eugene1028csh/RISC-V-NNA-SoC/docs/hardware/fpga_healthy2.jpeg

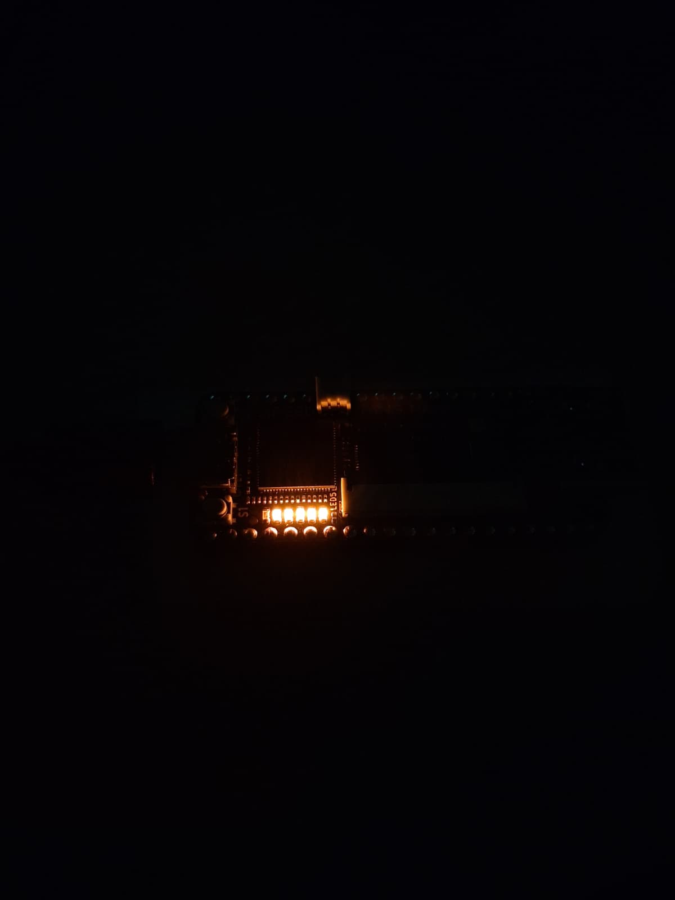
docs/hardware/fpga_healthy2.jpeg
