eugene1028csh/RISC-V-NNA-SoC/rtl/cpu/rv32i_core.sv

import rv32i_types::*;

module rv32i_core (
    input logic clk,
    input logic reset,
    input  logic nna_boot_pass_i,
    output logic core_dft_ready_o,

    //mmio ports
    output logic [31:0] bus_addr,
    output logic [31:0] bus_write_data,
    output logic        bus_write_en,

    input  logic [31:0] bus_read_data,
    input  logic        bus_hit,
    
    // MBIST status
    output logic        mbist_pass_o,
    output logic        mbist_fail_o,

    output logic alu_lbist_pass_o,
    output logic crc_lbist_pass_o
    
);
    logic [31:0] pc;
    logic [31:0] next_pc;
    logic [31:0] pc_plus4;
    logic [31:0] instruction;

    logic [4:0]  rs1_addr;
    logic [4:0]  rs2_addr;
    logic [4:0]  rd_addr;

    logic [31:0] rs1_data;
    logic [31:0] rs2_data;
    logic [31:0] writeback_data;

    logic [31:0] immediate;

    logic [31:0] alu_a;
    logic [31:0] alu_b;
    logic [31:0] alu_result;
    logic        alu_lbist_mode;
    logic [31:0] alu_lbist_a;
    logic [31:0] alu_lbist_b;
    alu_op_t     alu_lbist_op;
    logic        alu_lbist_start;
    logic        alu_lbist_busy;
    logic        alu_lbist_done;
    logic        alu_lbist_pass;
    logic        alu_lbist_fail;
    logic [31:0] alu_lbist_signature;
    logic alu_lbist_started;
    logic alu_lbist_boot_pass;

    logic [31:0] mem_read_data;
    logic [31:0] dmem_read_data;
    logic [31:0] crc_result;
    logic        crc_lbist_mode;
    logic        crc_lbist_start;
    logic        crc_lbist_busy;
    logic        crc_lbist_done;
    logic        crc_lbist_pass;
    logic        crc_lbist_fail;

    logic [31:0] crc_lbist_signature;
    logic crc_lbist_started;
    logic crc_lbist_boot_pass;
    logic [31:0] crc_lbist_rs1_data;
    logic [31:0] crc_lbist_rs2_data;
    logic [1:0]  crc_lbist_sel;
    logic        crc_ready;
    logic        crc_writeback;
    logic        crc_illegal;

    logic        reg_write;
    logic        alu_src;
    logic        alu_a_pc;
    logic        mem_write;
    logic        branch;
    logic        branch_taken;
    logic        jump;
    logic        jalr;

    alu_op_t      alu_op;
    imm_type_t    imm_type;
    result_src_t  result_src;

    // CPU-side DMEM signals
    logic [31:0] cpu_dmem_addr;
    logic [31:0] cpu_dmem_wdata;
    logic        cpu_dmem_we;

    // MBIST-side DMEM signals
    logic [31:0] mbist_mem_addr;
    logic [31:0] mbist_mem_wdata;
    logic        mbist_mem_we;

    logic        mbist_start;
    logic        mbist_busy;
    logic        mbist_done;
    logic        mbist_pass;
    logic        mbist_fail;
    logic [31:0] mbist_fail_addr;

    logic       repair_valid; //spare mapping is active
    logic [7:0] repair_addr; //which logical word gets redirected
    logic       repair_attempted; //we've already consumed our one spare

    // Actual signals entering physical DMEM
    logic [31:0] dmem_addr_mux;
    logic [31:0] dmem_wdata_mux;
    logic        dmem_we_mux;

    logic mbist_started;
    logic mbist_boot_pass;

    logic cpu_enable;
    logic cpu_reset;

    //instantiating pc
    rv32i_pc pc_unit (
        .clk(clk),
        .reset(cpu_reset),
        .next_pc(next_pc),
        .pc(pc)
    );

    //connect pc to imem
    rv32i_imem imem (
        .addr(pc),
        .instruction(instruction)
    );

    //instruction field extration for register addresses
    assign rs1_addr = instruction[19:15];
    assign rs2_addr = instruction[24:20];
    assign rd_addr  = instruction[11:7];

    xicrc_accelerator_unit xicrc_unit (
        .ext_rs1_data (
            crc_lbist_mode ? crc_lbist_rs1_data : rs1_data
        ),
        .ext_rs2_data (
            crc_lbist_mode ? crc_lbist_rs2_data : rs2_data
        ),
        .ext_funct7 (
            crc_lbist_mode ? 7'b1000000 : instruction[31:25]
        ),
        .ext_funct3 (
            crc_lbist_mode ? {1'b0, crc_lbist_sel} : instruction[14:12]
        ),

        .ext_ready     (crc_ready),
        .ext_result    (crc_result),
        .ext_writeback (crc_writeback),
        .ext_illegal   (crc_illegal)
    );

    rv32i_xicrc_lbist #(
        .USE_EXTERNAL_CRC(1'b1)
    ) crc_lbist_inst (
        .clk                 (clk),
        .reset               (reset),
        .start               (crc_lbist_start),

        .inject_fault        (1'b0),
        .fault_bit           (4'd0),
        .fault_stuck_at      (1'b0),

        .external_crc_result (crc_result[15:0]),

        .busy                (crc_lbist_busy),
        .done                (crc_lbist_done),
        .pass                (crc_lbist_pass),
        .fail                (crc_lbist_fail),

        .signature           (crc_lbist_signature),

        .test_rs1_data       (crc_lbist_rs1_data),
        .test_rs2_data       (crc_lbist_rs2_data),
        .test_crc_sel        (crc_lbist_sel)
    );

    assign crc_lbist_mode  = crc_lbist_busy;
    assign crc_lbist_start = alu_lbist_boot_pass && !crc_lbist_started;

    //instantiating decoder
    rv32i_decoder decoder (
        .instruction(instruction),
        .reg_write(reg_write),
        .alu_src(alu_src),
        .alu_a_pc(alu_a_pc),
        .mem_write(mem_write),
        .result_src(result_src),
        .branch(branch),
        .jump(jump),
        .jalr(jalr),
        .alu_op(alu_op),
        .imm_type(imm_type)
    );

    //reg file
    rv32i_regfile regfile (
    .clk(clk),
    .write_en(reg_write && cpu_enable), //connect the register file’s write_en input to the core’s reg_write signal.
    .rs1_addr(rs1_addr),
    .rs2_addr(rs2_addr),
    .wr_addr(rd_addr),
    .wr_data(writeback_data),
    .rs1_data(rs1_data),
    .rs2_data(rs2_data)
    );

    //immediate generator
    rv32i_imme_gnrtr immgen (
    .instruction(instruction),
    .imm_type(imm_type),
    .immediate(immediate)
    );

    assign alu_a = alu_a_pc ? pc : rs1_data;
    assign alu_b = alu_src ? immediate : rs2_data;
    assign alu_lbist_mode  = alu_lbist_busy;
    assign alu_lbist_start = mbist_boot_pass && !alu_lbist_started;

    rv32i_alu alu (
        .operand_a(alu_lbist_mode ? alu_lbist_a : alu_a),
        .operand_b(alu_lbist_mode ? alu_lbist_b : alu_b),
        .alu_op   (alu_lbist_mode ? alu_lbist_op : alu_op),
        .result   (alu_result)
    );

    rv32i_alu_lbist #(
        .USE_EXTERNAL_ALU(1'b1)
    ) alu_lbist_inst (
        .clk                 (clk),
        .reset               (reset),
        .start               (alu_lbist_start),

        .inject_fault        (1'b0),
        .fault_bit           (5'd0),
        .fault_stuck_at      (1'b0),

        .external_alu_result (alu_result),

        .busy                (alu_lbist_busy),
        .done                (alu_lbist_done),
        .pass                (alu_lbist_pass),
        .fail                (alu_lbist_fail),

        .signature           (alu_lbist_signature),

        .test_operand_a      (alu_lbist_a),
        .test_operand_b      (alu_lbist_b),
        .test_alu_op         (alu_lbist_op)
    );

    rv32i_branch_unit branch_unit (
        .rs1_data(rs1_data),
        .rs2_data(rs2_data),

        .funct3(instruction[14:12]),

        .branch_taken(branch_taken)
    );

    assign bus_addr =
        cpu_enable ? alu_result : 32'h0000_0000;

    assign bus_write_data =
        cpu_enable ? rs2_data : 32'h0000_0000;

    assign bus_write_en =
        mem_write && cpu_enable;

    rv32i_dmem dmem (
        .clk(clk),
        .mem_write(dmem_we_mux),

        .addr(dmem_addr_mux),
        .write_data(dmem_wdata_mux),

        .read_data(dmem_read_data),

        .repair_addr  (repair_addr),
        .repair_valid (repair_valid)
    );

    assign cpu_dmem_addr  = alu_result;
    assign cpu_dmem_wdata = rs2_data;
    assign cpu_dmem_we =    mem_write && !bus_hit && cpu_enable;
    assign dmem_addr_mux =
        mbist_busy ? mbist_mem_addr : cpu_dmem_addr;

    assign dmem_wdata_mux =
        mbist_busy ? mbist_mem_wdata : cpu_dmem_wdata;

    assign dmem_we_mux =
        mbist_busy ? mbist_mem_we : cpu_dmem_we;
    
    assign alu_lbist_pass_o = alu_lbist_boot_pass;
    assign crc_lbist_pass_o = crc_lbist_boot_pass;

    assign core_dft_ready_o =
        mbist_boot_pass &&
        alu_lbist_boot_pass &&
        crc_lbist_boot_pass;

    assign cpu_enable =
        core_dft_ready_o && nna_boot_pass_i;

    assign cpu_reset = reset || !cpu_enable;

    assign mbist_pass_o = mbist_pass;
    assign mbist_fail_o = mbist_fail;
    dmem_mbist #(
        .ADDR_WIDTH(8)
    ) mbist_inst (
        .clk       (clk),
        .reset     (reset),
        .start     (mbist_start),

        .busy      (mbist_busy),
        .done      (mbist_done),
        .pass      (mbist_pass),
        .fail      (mbist_fail),

        .mem_we    (mbist_mem_we),
        .mem_addr  (mbist_mem_addr),
        .mem_wdata (mbist_mem_wdata),
        .mem_rdata (dmem_read_data),

        .fail_addr (mbist_fail_addr)

        
    );

    always_ff @(posedge clk) begin
        if (reset) begin
            mbist_start     <= 1'b0;
            mbist_started   <= 1'b0;
            mbist_boot_pass <= 1'b0;

            repair_valid     <= 1'b0;
            repair_addr      <= '0;
            repair_attempted <= 1'b0;

        end else begin

            // Default: START is only a one-clock pulse
            mbist_start <= 1'b0;

            // Initial POR
            if (!mbist_started) begin
                mbist_start   <= 1'b1;
                mbist_started <= 1'b1;
            end

            // MBIST finished successfully
            if (mbist_done && mbist_pass) begin
                mbist_boot_pass <= 1'b1;
            end

            //firts MBISt failure
            //allocates 1 spare and reruns mbist when fail
            else if (mbist_done && mbist_fail && !repair_attempted) begin
                repair_addr <= mbist_fail_addr[9:2];
                repair_valid <= 1'b1;
                repair_attempted <= 1'b1;

                //run mbist agin through rpaired mapping
                mbist_start <= 1'b1;
            end

            //if retest fails, no more spares left
            else if (mbist_done && mbist_fail && repair_attempted)
                mbist_boot_pass <= 1'b0;
        end
    end

    always_ff @(posedge clk) begin
        if (reset) begin
            alu_lbist_started   <= 1'b0;
            alu_lbist_boot_pass <= 1'b0;
        end
        else begin
            if (alu_lbist_start)
                alu_lbist_started <= 1'b1;

            if (alu_lbist_done && alu_lbist_pass)
                alu_lbist_boot_pass <= 1'b1;
        end
    end

    always_ff @(posedge clk) begin
        if (reset) begin
            crc_lbist_started   <= 1'b0;
            crc_lbist_boot_pass <= 1'b0;
        end
        else begin
            if (crc_lbist_start)
                crc_lbist_started <= 1'b1;

            if (crc_lbist_done && crc_lbist_pass)
                crc_lbist_boot_pass <= 1'b1;
        end
    end

    assign mem_read_data = bus_hit ? bus_read_data : dmem_read_data;
    assign pc_plus4 = pc + 32'd4;

    always_comb begin

        case (result_src)

            RES_ALU:
                writeback_data = alu_result;

            RES_MEM:
                writeback_data = mem_read_data;

            RES_PC4:
                writeback_data = pc_plus4;

            RES_IMM:
                writeback_data = immediate;

            RES_CRC:
                writeback_data = crc_result;

            default:
                writeback_data = 32'd0;

        endcase

    end

 rv32i_next_pc next_pc_unit (
        .pc(pc),
        .immediate(immediate),

        .branch(branch),
        .branch_taken(branch_taken),

        .jump(jump),
        .jalr(jalr),

        .rs1_data(rs1_data),

        .next_pc(next_pc)
    );

endmodule
