eugene1028csh/RISC-V-NNA-SoC/rtl/nna/pe_array_4x4.vhd

library ieee;
use ieee.std_logic_1164.all;
use ieee.numeric_std.all;

entity pe_array_4x4 is
  port (
    clk    : in std_logic;
    reset  : in std_logic;
    enable : in std_logic;

    a_row0_in : in signed(7 downto 0);
    a_row1_in : in signed(7 downto 0);
    a_row2_in : in signed(7 downto 0);
    a_row3_in : in signed(7 downto 0);
    b_col0_in : in signed(7 downto 0);
    b_col1_in : in signed(7 downto 0);
    b_col2_in : in signed(7 downto 0);
    b_col3_in : in signed(7 downto 0);

    a_row0_out : out signed(7 downto 0);
    a_row1_out : out signed(7 downto 0);
    a_row2_out : out signed(7 downto 0);
    a_row3_out : out signed(7 downto 0);
    b_col0_out : out signed(7 downto 0);
    b_col1_out : out signed(7 downto 0);
    b_col2_out : out signed(7 downto 0);
    b_col3_out : out signed(7 downto 0);

    result00 : out signed(31 downto 0);
    result01 : out signed(31 downto 0);
    result10 : out signed(31 downto 0);
    result11 : out signed(31 downto 0);

    result02 : out signed(31 downto 0);
    result03 : out signed(31 downto 0);
    result12 : out signed(31 downto 0);
    result13 : out signed(31 downto 0);

    result20 : out signed(31 downto 0);
    result21 : out signed(31 downto 0);
    result30 : out signed(31 downto 0);
    result31 : out signed(31 downto 0);

    result22 : out signed(31 downto 0);
    result23 : out signed(31 downto 0);
    result32 : out signed(31 downto 0);
    result33 : out signed(31 downto 0)
  );
end entity;

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
b_in => b_22_32,

a_out => a_32_33,
b_out => b_col2_out,

result => result32
);

pe33 : entity work.pe
port map(
clk => clk,
reset => reset, 
enable => enable,

a_in => a_32_33,
b_in => b_23_33,

a_out => a_row3_out,
b_out => b_col3_out,

result => result33
);







end architecture;
