eugene1028csh/RISC-V-NNA-SoC/tb/rv32i_core_dft_tb.sv

`timescale 1ns/1ps

module rv32i_core_dft_tb;

logic clk = 0;
logic reset = 1;

logic [31:0] bus_addr;
logic [31:0] bus_write_data;
logic bus_write_en;

logic mbist_pass_o;
logic mbist_fail_o;

always #5 clk = ~clk;

rv32i_core dut (
    .clk(clk),
    .reset(reset),

    .bus_addr(bus_addr),
    .bus_write_data(bus_write_data),
    .bus_write_en(bus_write_en),

    .bus_read_data(32'd0),
    .bus_hit(1'b0),

    .mbist_pass_o(mbist_pass_o),
    .mbist_fail_o(mbist_fail_o),
    .nna_boot_pass_i(1'b1),
    .core_dft_ready_o()
);

initial begin
    $dumpfile("docs/waveforms/cpu_dft.vcd");
    $dumpvars(0, rv32i_core_dft_tb);
end

initial begin
    repeat (5) @(negedge clk);
    reset = 0;

    // Stage 1: Memory testing
    wait(dut.mbist_boot_pass == 1'b1);
    $display("MBIST PASSED");

    if (dut.cpu_enable !== 1'b0)
        $fatal(1, "CPU enabled before ALU LBIST");

    // Stage 2: ALU testing
    wait(dut.alu_lbist_busy == 1'b1);
    $display("ALU LBIST STARTED");

    if (dut.pc !== 32'd0)
        $fatal(1, "CPU PC changed during LBIST");

    wait(dut.alu_lbist_done == 1'b1);
    #1;

    $display("ALU SIGNATURE = %h",
             dut.alu_lbist_signature);

    if (dut.alu_lbist_pass !== 1'b1 ||
        dut.alu_lbist_fail !== 1'b0 ||
        dut.alu_lbist_signature !== 32'h6A86_A2B4)
        $fatal(1, "CPU ALU LBIST FAILED");

    $display("ALU LBIST PASSED");

   // Stage 3: XiCRC LBIST
    wait(dut.crc_lbist_busy == 1'b1);
    $display("XiCRC LBIST STARTED");

    if (dut.cpu_enable !== 1'b0 || dut.pc !== 32'd0)
        $fatal(1, "CPU enabled before XiCRC LBIST completed");

    wait(dut.crc_lbist_done == 1'b1);
    #1;

    $display("XiCRC SIGNATURE = %h",
            dut.crc_lbist_signature);

    if (dut.crc_lbist_pass !== 1'b1 ||
        dut.crc_lbist_fail !== 1'b0 ||
        dut.crc_lbist_signature !== 32'h561D52A3)
        $fatal(1, "CPU XiCRC LBIST FAILED");

    $display("XiCRC LBIST PASSED");

    // Stage 4: CPU release
    repeat (2) @(negedge clk);

    if (dut.cpu_enable !== 1'b1)
        $fatal(1, "CPU was not enabled");

    $display("CPU BOOT ENABLED");

    #1000;  // Keep simulation running for another 1 us
    $finish;
end

initial begin
    #100000;
    $fatal(1, "Simulation timeout");
end

endmodule
