eugene1028csh/RISC-V-NNA-SoC/tb/rv32i_fault_injection_mbist_tb.sv

`timescale 1ns/1ps

module dmem_mbist_fault_tb;

    localparam int DEPTH = 256;

    logic clk;
    logic reset;
    logic start;

    logic busy;
    logic done;
    logic pass;
    logic fail;

    logic        mem_we;
    logic [31:0] mem_addr;
    logic [31:0] mem_wdata;
    logic [31:0] mem_rdata;

    logic [31:0] fail_addr;

    logic [31:0] mem [0:DEPTH-1];


    // ----------------------------
    // DUT
    // ----------------------------

    dmem_mbist #(
        .ADDR_WIDTH(8)
    ) dut (
        .clk       (clk),
        .reset     (reset),
        .start     (start),

        .busy      (busy),
        .done      (done),
        .pass      (pass),
        .fail      (fail),

        .mem_we    (mem_we),
        .mem_addr  (mem_addr),
        .mem_wdata (mem_wdata),
        .mem_rdata (mem_rdata),

        .fail_addr (fail_addr)
    );


    // ----------------------------
    // Clock
    // ----------------------------

    initial begin
        clk = 1'b0;
        forever #5 clk = ~clk;
    end


    // ----------------------------
    // Memory model
    // ----------------------------

    assign mem_rdata = mem[mem_addr[9:2]];

    always_ff @(posedge clk) begin
        if (mem_we) begin

            // Inject stuck-at-0 fault:
            // word 37, bit 7
            if (mem_addr[9:2] == 8'd37) begin
                mem[37] <= mem_wdata & 32'hFFFF_FF7F;
                //forces bit 7 to always be zero whenever word 37 is written.
            end

            else begin
                mem[mem_addr[9:2]] <= mem_wdata;
            end

        end
    end


    // ----------------------------
    // Test sequence
    // ----------------------------

    initial begin

        reset = 1'b1;
        start = 1'b0;

        repeat (5) @(posedge clk);

        reset = 1'b0;

        // One-cycle START pulse
        @(posedge clk);
        start = 1'b1;

        @(posedge clk);
        start = 1'b0;


        // Wait until entire MBIST finishes
        wait (done == 1'b1);

        #1;

        $display("-------------------------------");
        $display("MBIST finished");
        $display("PASS      = %b", pass);
        $display("FAIL      = %b", fail);
        $display("FAIL ADDR = %h", fail_addr);
        $display("-------------------------------");


        if (fail !== 1'b1)
            $error("MBIST failed to detect injected fault");

        if (pass !== 1'b0)
            $error("PASS incorrectly asserted");

        if (fail_addr !== 32'h0000_0094)
            $error(
                "Wrong failure address. Expected 0x00000094, got %h",
                fail_addr
            );

        if (
            fail       === 1'b1 &&
            pass       === 1'b0 &&
            fail_addr  === 32'h0000_0094
        )
            $display("TEST PASSED: stuck-at-0 fault correctly detected");


        $finish;

    end

endmodule
