eugene1028csh/RISC-V-NNA-SoC/rtl/cpu/rv32i_next_pc.sv

module rv32i_next_pc(
    input  logic [31:0] pc,
    input  logic [31:0] immediate,
    input  logic        branch,
    input  logic        branch_taken,
    input logic jump,
    input logic [31:0] rs1_data,
    input logic jalr,
    output logic [31:0] next_pc
);
always_comb begin
    next_pc = pc + 32'd4;

    if (branch && branch_taken)
        next_pc = pc + immediate;

    if (jump) begin
        if (jalr)
            next_pc = (rs1_data + immediate) & 32'hFFFFFFFE;
        else
            next_pc = pc + immediate;
        
    end
    
end
endmodule
