eugene1028csh/RISC-V-NNA-SoC/(commit log)

2026-10-29 led changes, error latch
2026-10-29 mbist in soct top led
